7918514/MEGA-Tinyjoypad-for-ESP8266/schemes/List of Elements v1.1.pdf

### Перечень элементов v1.1

BAT | = 3V7 602540 (6mm*25mm*40mm)
C1 | = 100n (0805)
C2 | = 100n (0805)
C3 | = 470uF*6.3V (Tantal Case E)
C4 | = 100n (0805)
C5 | = 10uF (0805)
C6 | = 10uF (0805)
C7 | = 22uF (0805)
C8 | = 22uF (0805)
C9 | = 10uF (0805)
C10 | = 10uF (0805)
D1 | = SK34 (SMA (DO-214AC))
D2 | = SK34 (SMA (DO-214AC))
D3 | = SK34 (SMA (DO-214AC))
D4 | = Red (0805)
D5 | = Green (0805 (KPBA-3010ESGC))
D6 | = RS1M (SMA (DO-214AC))
D7 | = RS1M (SMA (DO-214AC))
D8 | = White (d=3mm)
JP1 | = ПП (Перемычка припоем)
JP2 | = ПП (Перемычка припоем)
JP3 | = ПП (Перемычка припоем)
K1 | = MSK-12D19 (ISF-1260) Link1 (https://aliexpress.ru/item/4001202080623.html?sku_id=10000015286215548) Link2 (https://aliexpress.ru/item/1005004659954284.html?sku_id=12000034673467435) Link3 (https://aliexpress.ru/item/33009763749.html?sku_id=67133660852)
K2 | = MSK-12C02 (IS-1290A) Link1 (https://aliexpress.ru/item/4000685483225.html?sku_id=12000037044894568)
K3 | = MSK-12C02 (IS-1290A)
K4 | = MSK-12C02 (IS-1290A)
L1 | = 10uH (SH4028-100YLB)
M1 | = Vibration Motor (Eccentric Rotating Mass (∅8x3.4mm)) (https://aliexpress.ru/item/1005006072681788.html)
Q1 | = WM02P60M2 (SOT-23-3 P-Channel MOSFET)
Q2 | = WM02N28M (SOT-23-3 N-Channel MOSFET)
Q3 | = WM02N28M (SOT-23-3 N-Channel MOSFET)
Q4 | = WM02N28M (SOT-23-3 N-Channel MOSFET)
R1 | = 5k1 (0805)
R2 | = 5k1 (0805)
R3 | = 220k (0805)
R4 | = 62k (0805)
R5 | = 10k (0805)
R6 | = 10k (0805)
R7 | = 10k (0805)
R8 | = 10k (0805)
R9 | = 10k (0805)
R10 | = 10k (0805)
R11 | = 10k (0805)
R12 | = 10k (0805)
R13 | = 10k (0805)
R14 | = 10k (0805)
R15 | = 110k (0805 (или R15 220k + R16 30k))
R16 | = 15k (0805 (или R15 220k + R16 30k))
R17 | = 10k (0805)
R18 | = 1k (0805)
R19 | = 1k (510) (0805)
R20 | = 1k (470) (0805)
R21 | = 3k3 (0805)
R22 | = 1k (0805)
R23 | = 30k (0805)
R24 | = 1k (0805)
R25 | = 30k (0805)
R26 | = 10 (0805)
R27 | = 3362W-1-501 (Резистор переменный 500 Ом) (https://aliexpress.ru/item/1005001679113612.html)
R28 | = 1k (0805)
R29 | = 30k (0805)
R30 | = 47 (0805)
R* | = 10k (0805 (Не устанавливать))

S1 | = IT-1199 (https://aliexpress.ru/item/4001158109967.html) (RESET)
S2 | = IT-1199 (UP)
S3 | = IT-1199 (UP)
S4 | = IT-1199 (LEFT)
S5 | = IT-1199 (RIGHT)
S6 | = IT-1199 (DOWN)
S7 | = IT-1199 (START)
S8 | = IT-1199 (B)
S9 | = Кнопка тактовая (3.5x4.7mm) (https://aliexpress.ru/item/32802358763.html)
SP1 | = Passive Buzzer 0905 16R (9x5.5mm (hole 4.0mm)) (https://aliexpress.ru/item/32857436073.html)
U1 | = CH340N (SOP-8)
U2 | = OLED (SSD1306 1.54'' 128x64 I2C 4Pin DRIVER IC: 1309) (https://aliexpress.ru/item/1005004403427456.html)
U3 | = ESP12F (https://aliexpress.ru/item/32256161821.html)
U4 | = RT9013-33GB (ME6211C33) (SOT-23-5)
U5 | = SDB628 (SOT-23-6)
U6 | = TP4057 (SOT-23-6 (57b1))
X1 | = USB Type-C (DS1144-18-16FS8BNR0)
X2 | = DS1002-01-4 (Разъем цанговый, мама+папа) (https://aliexpress.ru/item/1005007331511033.html)
X3 | = CWF-5R (L-KLS1-2.50-05-R) (https://aliexpress.ru/item/1005003169239623.html)
Y1 | = Taptic Engine (iPhone 6) (https://aliexpress.ru/item/1005006289568035.html)

Стойка латунная М2.5*12мм (https://aliexpress.ru/item/1005004459634650.html) – 4шт

Стойка латунная М2.5*8мм (https://aliexpress.ru/item/1005004459634650.html) – 4шт

Винт М2.5*5мм (https://aliexpress.ru/item/1005002525560135.html) – 16шт

Винт М1.6*6мм (https://aliexpress.ru/item/1005002525560135.html) – 2шт (крепление Taptic Engine)

Гайка М1.6 (https://aliexpress.ru/item/1005002856385340.html) – 2шт (крепление Taptic Engine)

Крестик джойстика Gameboy Pocket GBP (https://aliexpress.ru/item/1005006164932167.html) – 1шт

Колпачок для кнопки 102 ∅7.5мм (https://aliexpress.ru/item/1005002085295869.html) – 3шт

Колпачок для кнопки A101 ∅5.5мм (https://aliexpress.ru/item/1005004784765029.html) – 1шт

Стекло защитное Xiaomi Miband 8 Pro (https://aliexpress.ru/item/1005006137168319.html) – 1шт (защита экрана)
