7918514/MEGA-Tinyjoypad-for-ESP8266/pcb/front_panel_v1.2.png

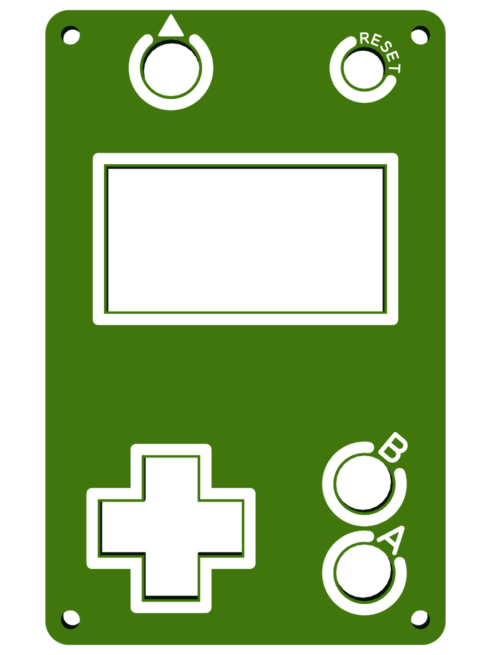
pcb/front_panel_v1.2.png
