7918514/MEGA-Tinyjoypad-for-ESP8266/pcb/main_board_v1.2_bot.png

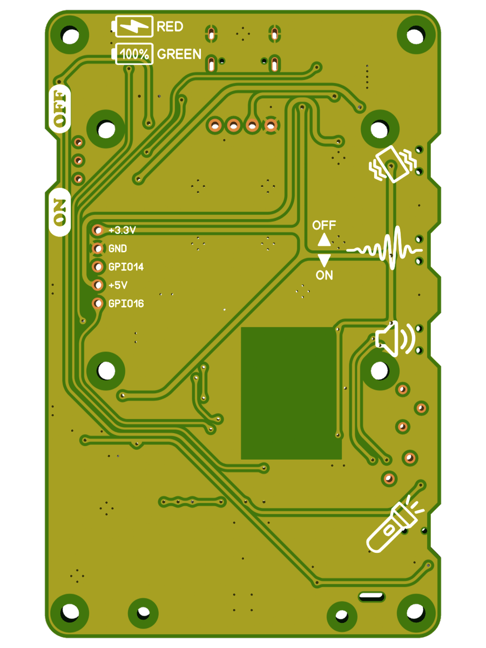
pcb/main_board_v1.2_bot.png
