7918514/MEGA-Tinyjoypad-for-ESP8266/pcb/main_board_v1.2_top.png

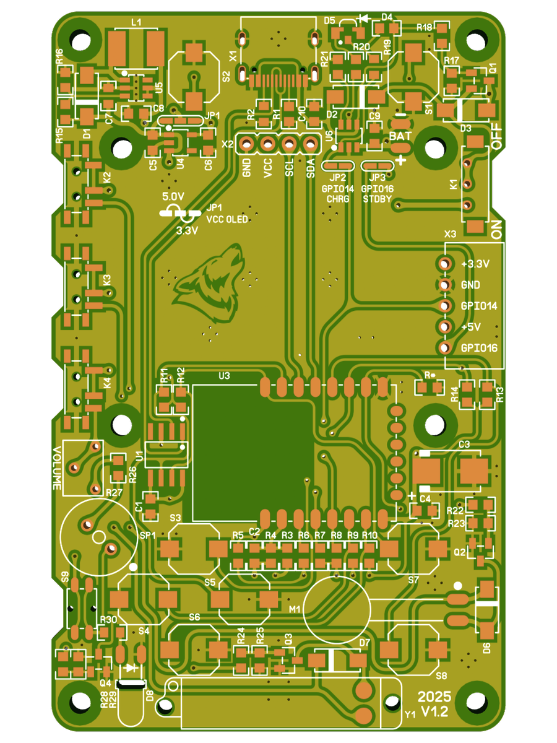
pcb/main_board_v1.2_top.png
