7918514/MEGA-Tinyjoypad-for-ESP8266/photo/001 front side.jpg

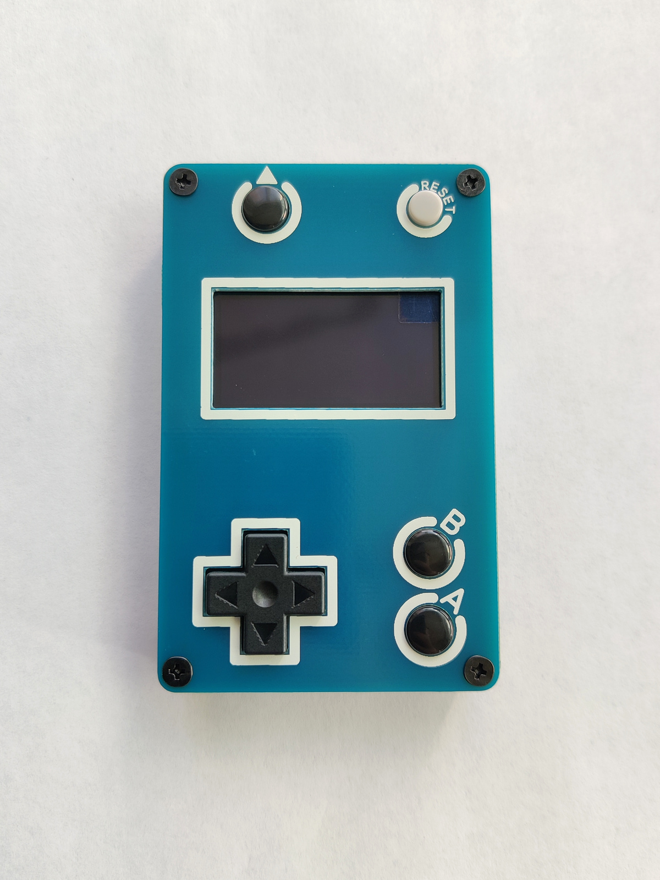
photo/001 front side.jpg
