7918514/MEGA-Tinyjoypad-for-ESP8266/photo/002 back side.jpg

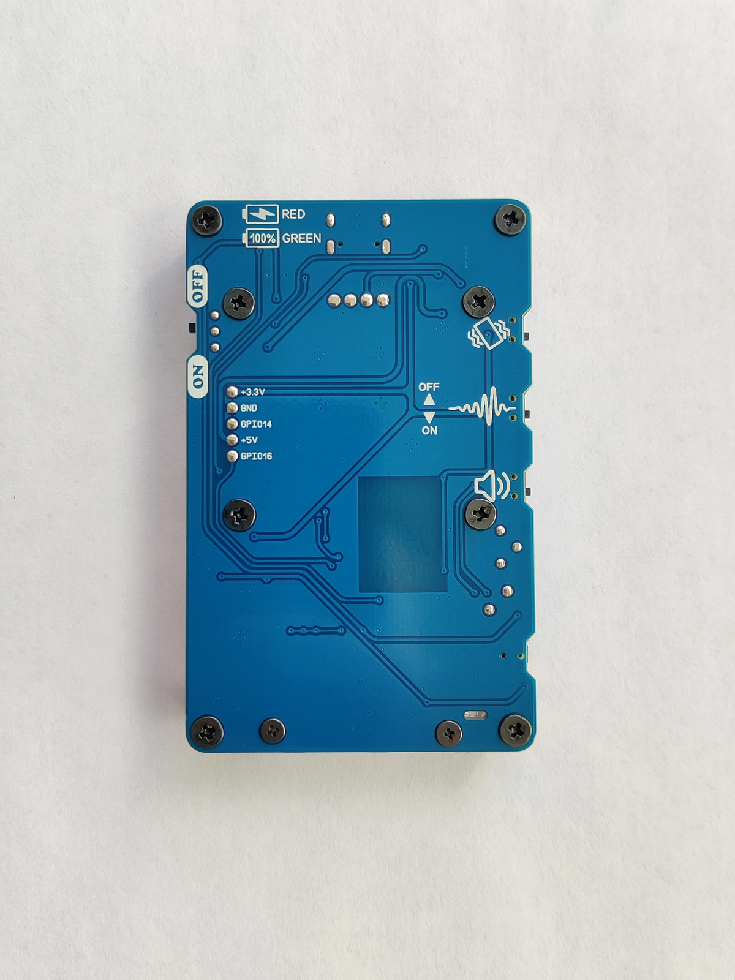
photo/002 back side.jpg
