7918514/MEGA-Tinyjoypad-for-ESP8266/photo/003.jpg

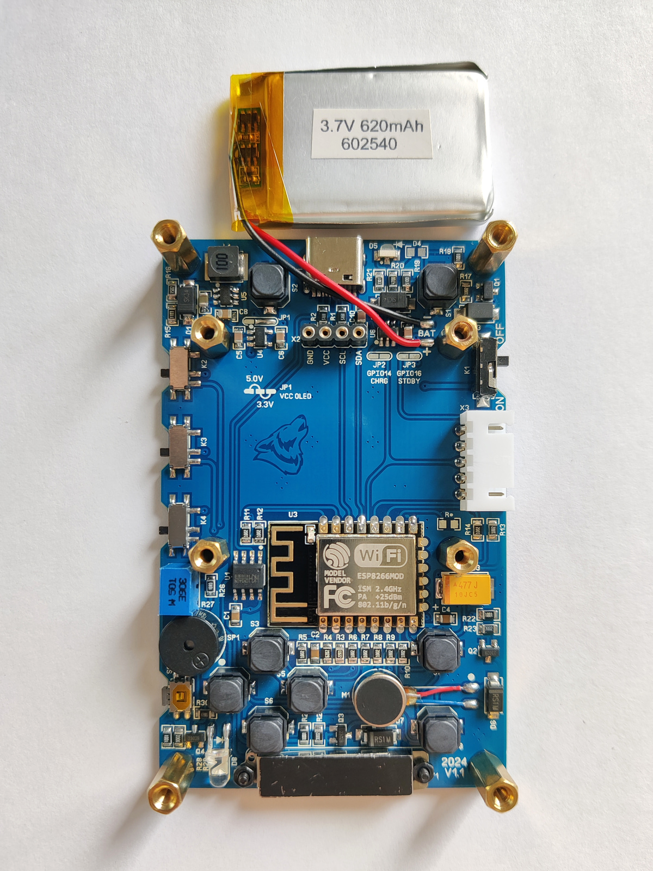
photo/003.jpg
