7918514/MEGA-Tinyjoypad-for-ESP8266/photo/004.jpg

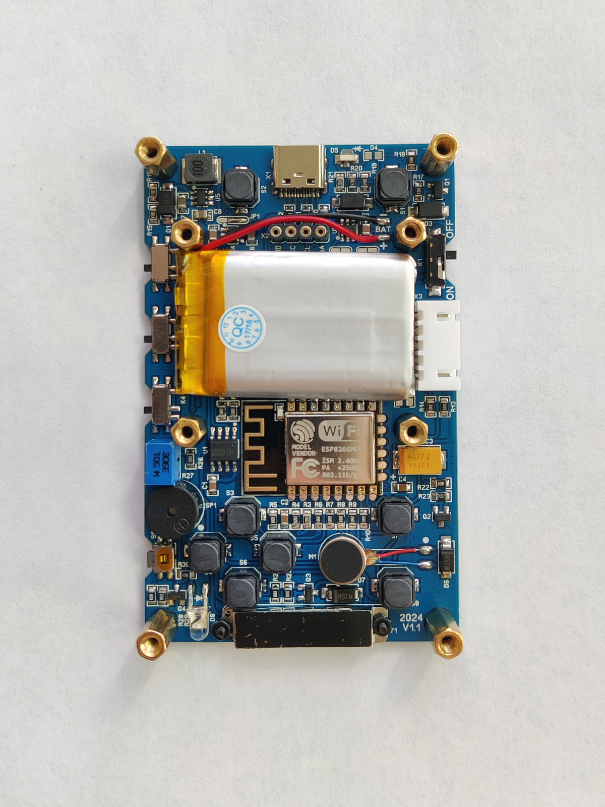
photo/004.jpg
