7918514/MEGA-Tinyjoypad-for-ESP8266/photo/005.jpg

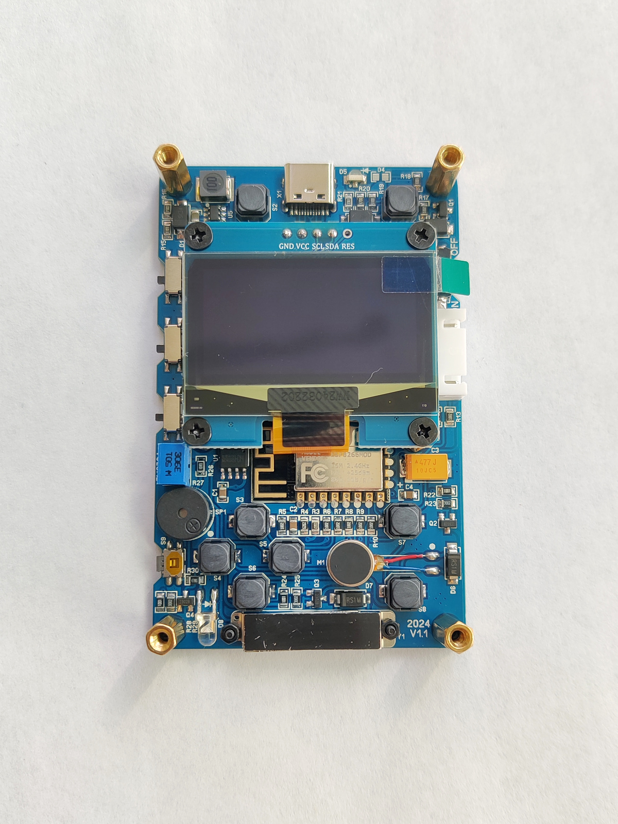
photo/005.jpg
