7918514/MEGA-Tinyjoypad-for-ESP8266/photo/006.jpg

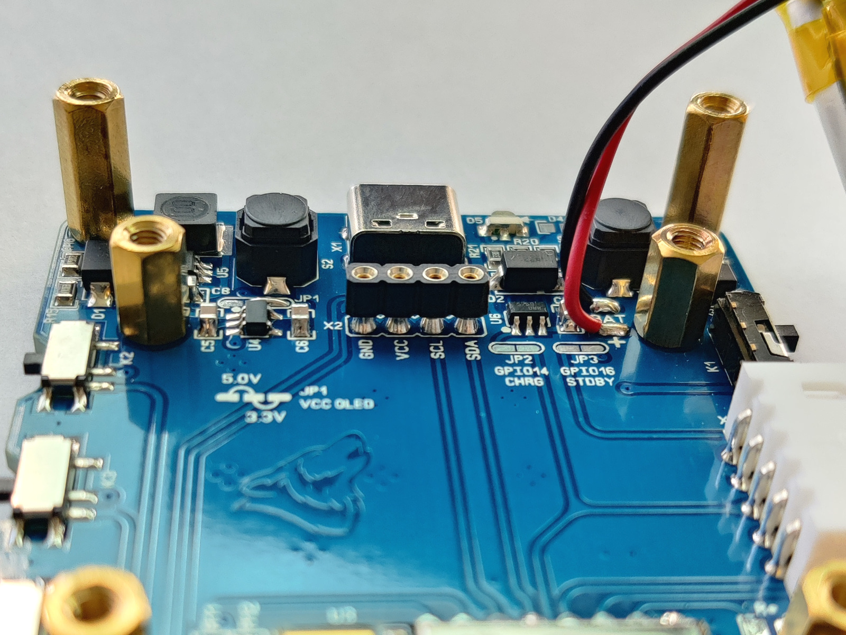
photo/006.jpg
