7918514/MEGA-Tinyjoypad-for-ESP8266/photo/007.jpg

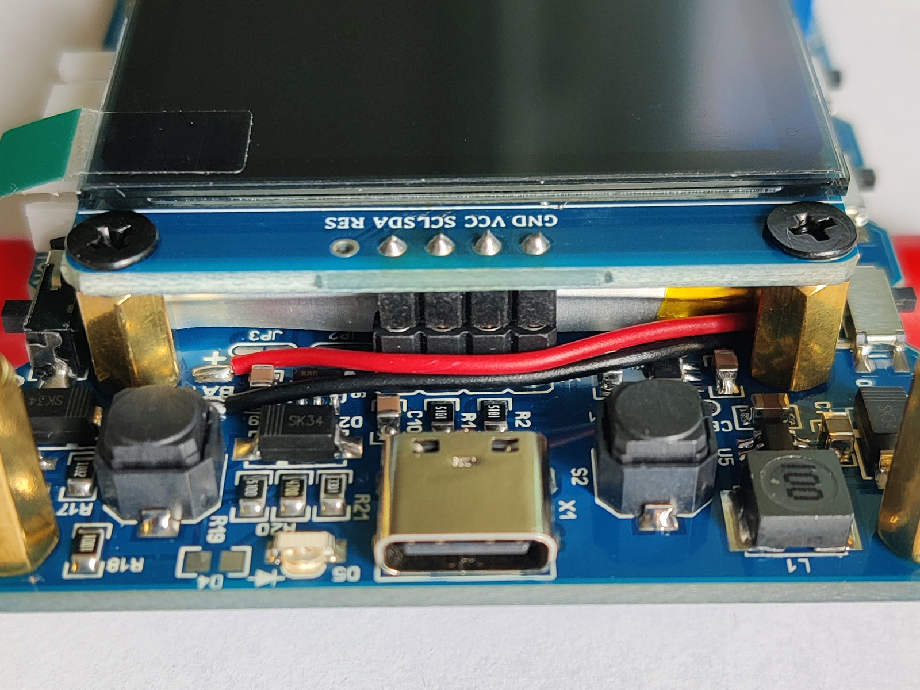
photo/007.jpg
