7918514/MEGA-Tinyjoypad-for-ESP8266/photo/008.jpg

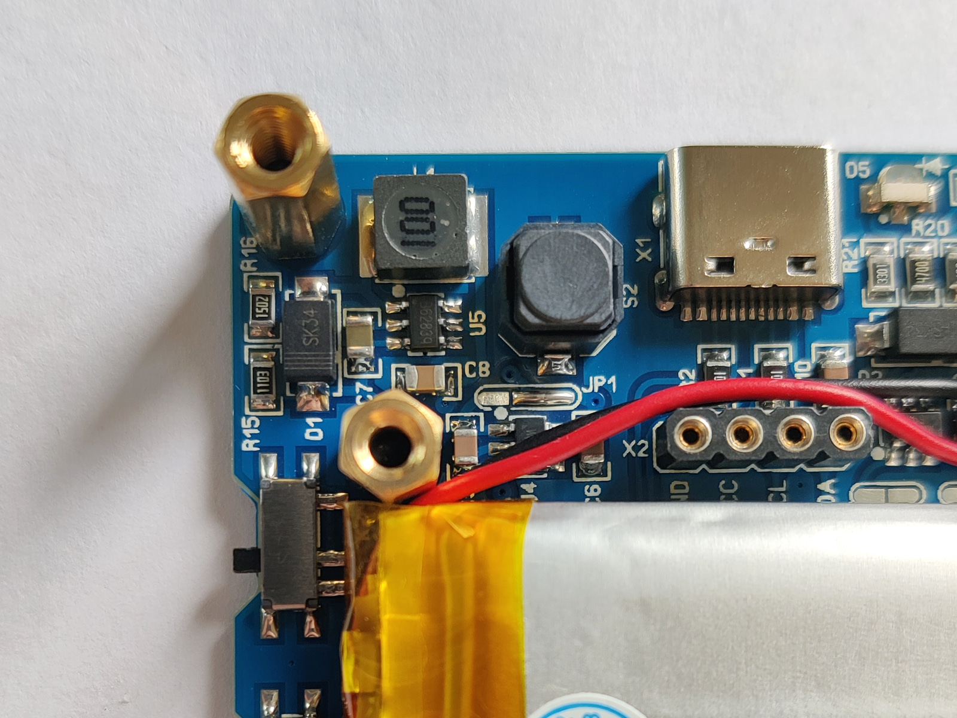
photo/008.jpg
