7918514/MEGA-Tinyjoypad-for-ESP8266/photo/009.jpg

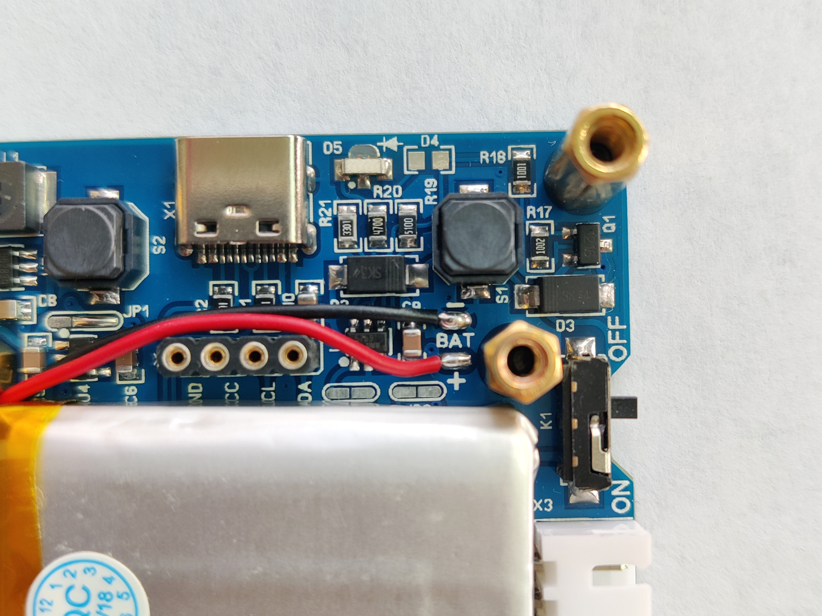
photo/009.jpg
