7918514/MEGA-Tinyjoypad-for-ESP8266/photo/010.jpg

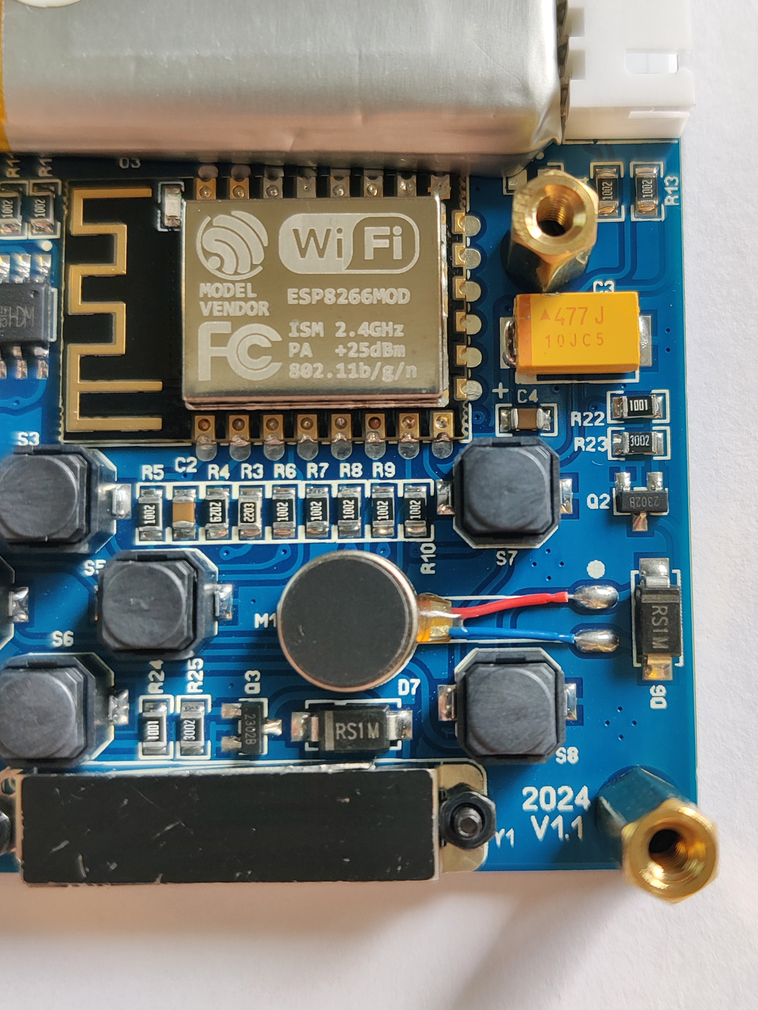
photo/010.jpg
