7918514/MEGA-Tinyjoypad-for-ESP8266/photo/011.jpg

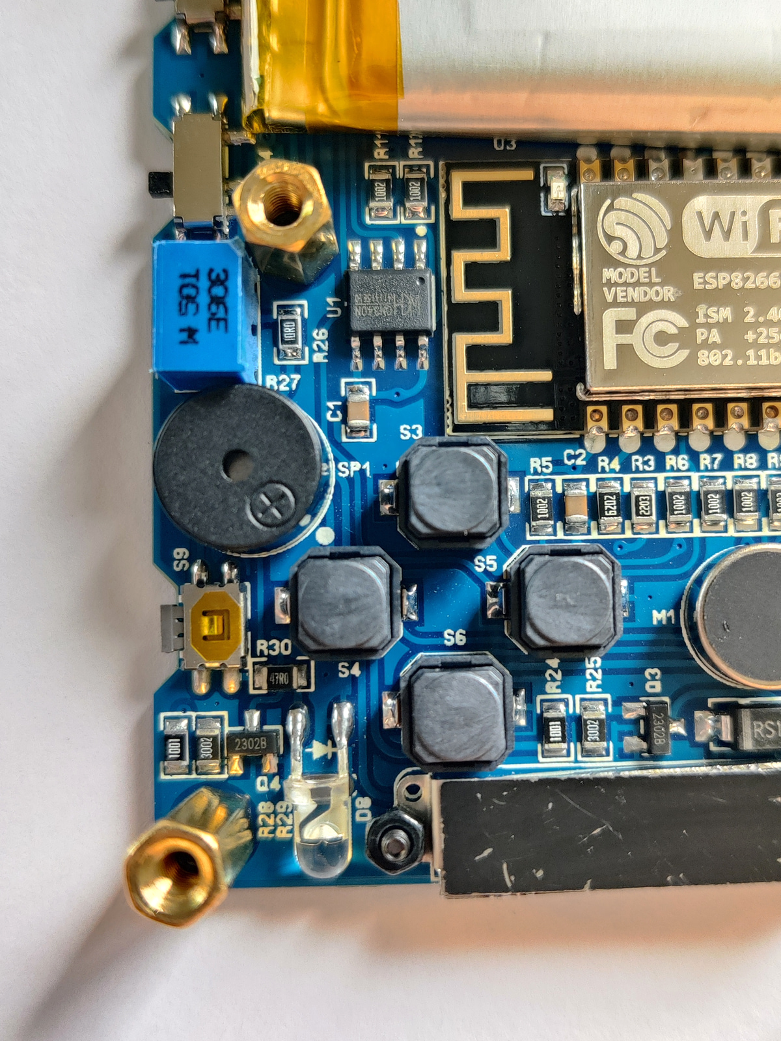
photo/011.jpg
