7918514/MEGA-Tinyjoypad-for-ESP8266/photo/buttons 1.jpg

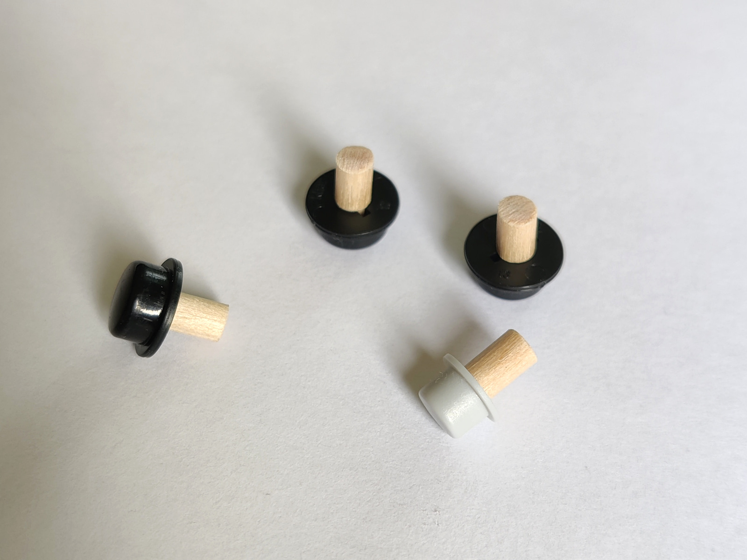
photo/buttons 1.jpg
