7918514/MEGA-Tinyjoypad-for-ESP8266/photo/buttons 2.jpg

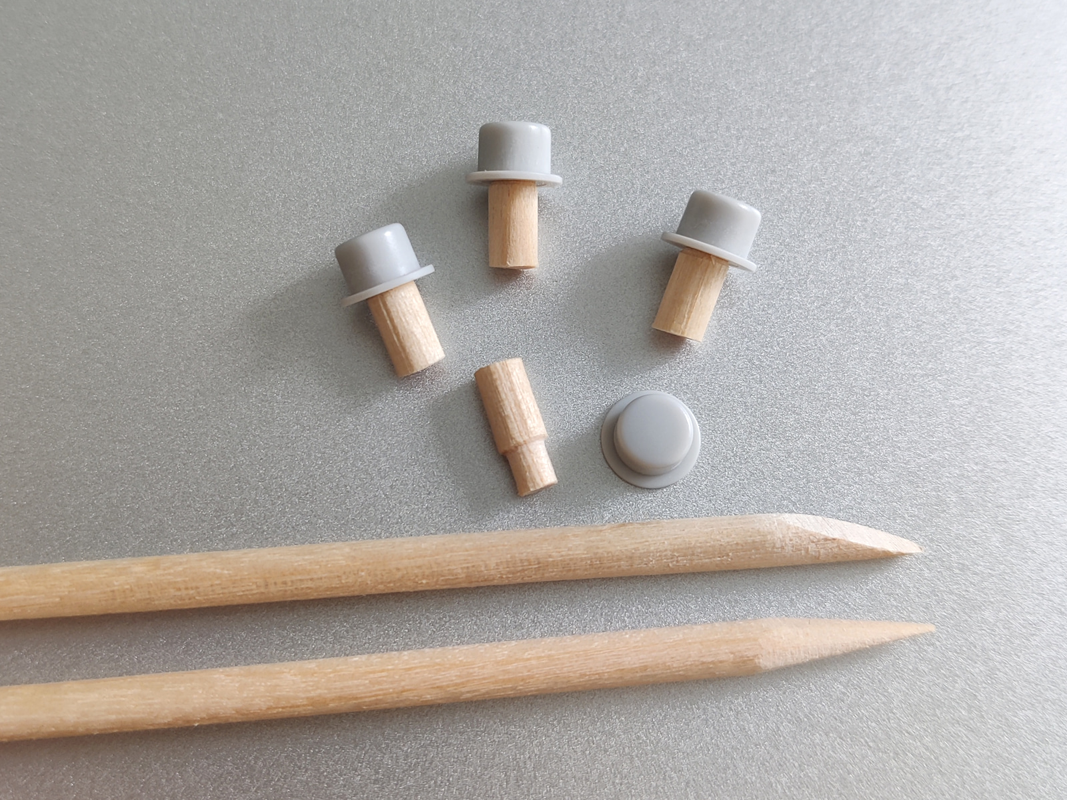
photo/buttons 2.jpg
