7918514/MEGA-Tinyjoypad-for-ESP8266/photo/display name.jpg

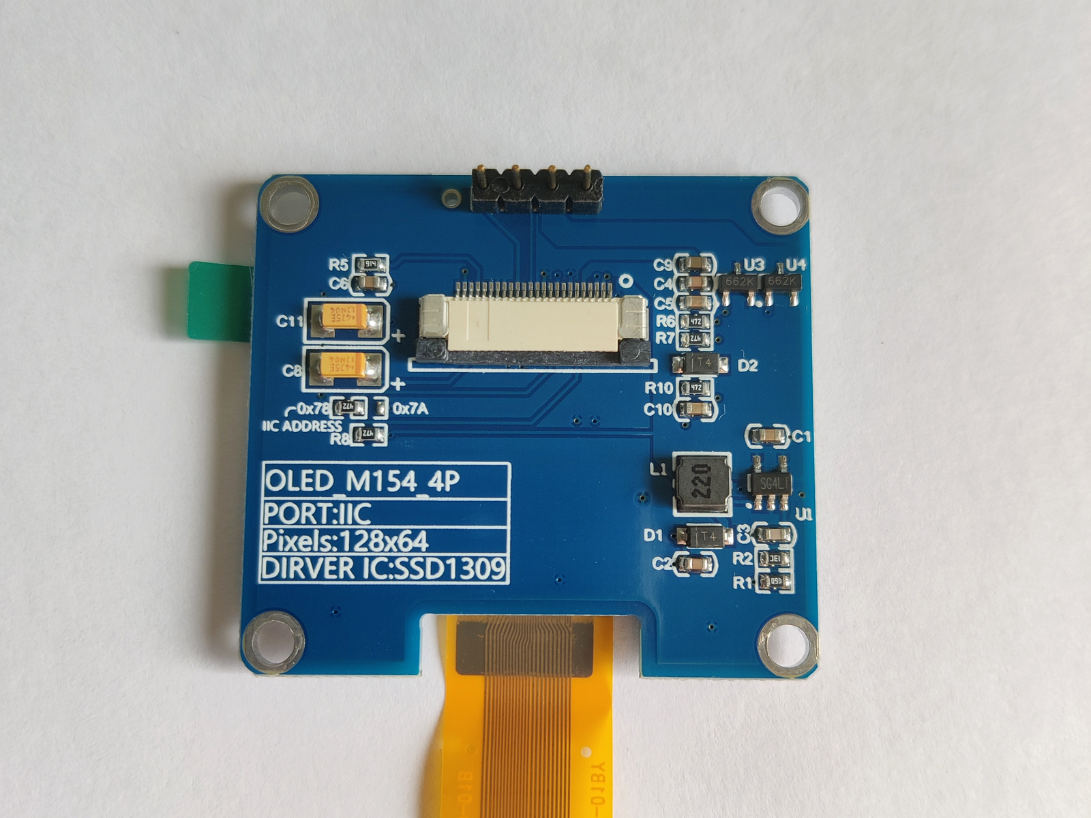
photo/display name.jpg
