7918514/MEGA-Tinyjoypad-for-ESP8266/photo/joystick.jpg

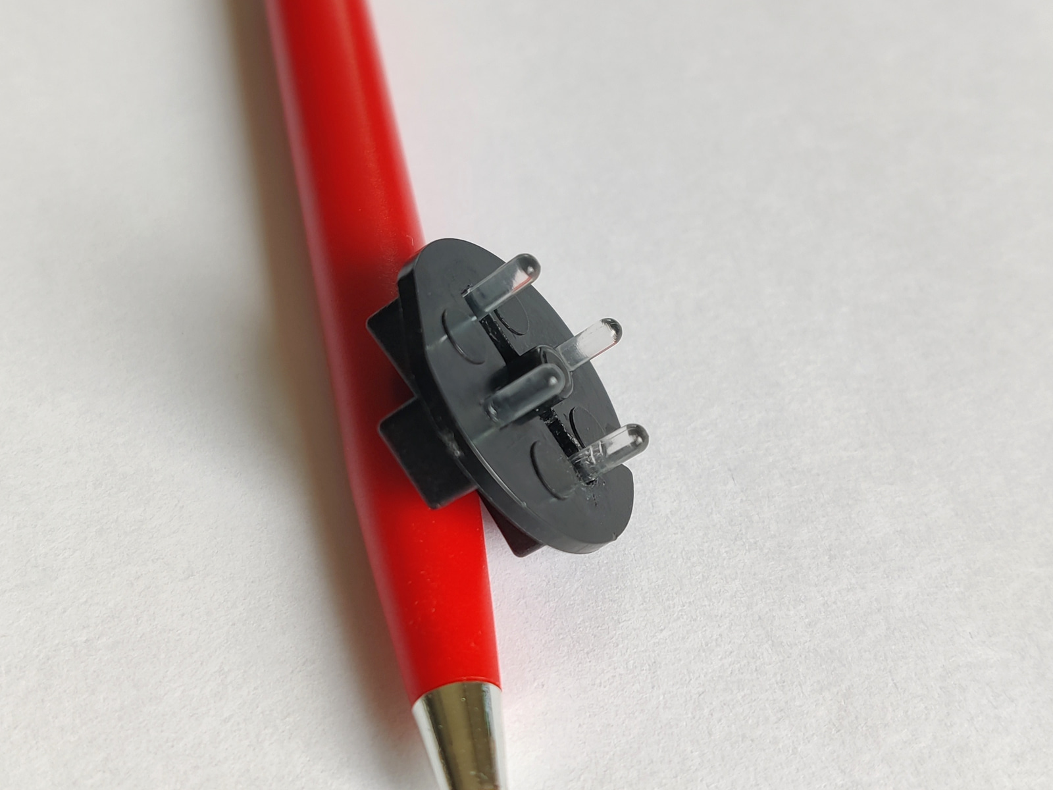
photo/joystick.jpg
