7918514/MEGA-Tinyjoypad-for-ESP8266/firmware/test/README.md

Разные прошивки для устройства не относящиеся к основному проекту
