7918514/MEGA-Tinyjoypad-for-ESP8266/firmware/test/battery_voltage_on_the_display/scheme.jpg

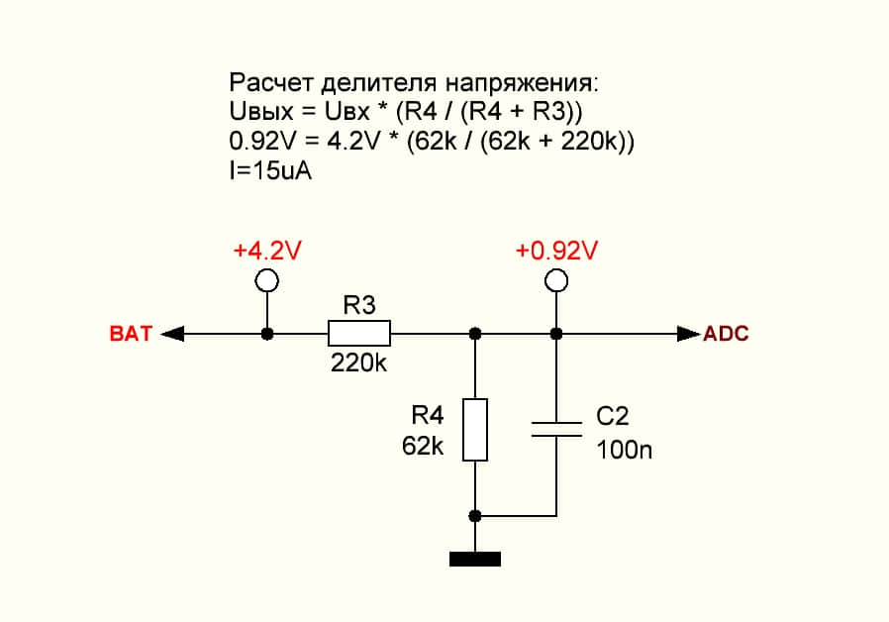
firmware/test/battery_voltage_on_the_display/scheme.jpg
