7918514/MEGA-Tinyjoypad-for-ESP8266/schemes/Schemes v1.1.pdf

# MEGA Tinyjoypad for ESP8266 v1.1

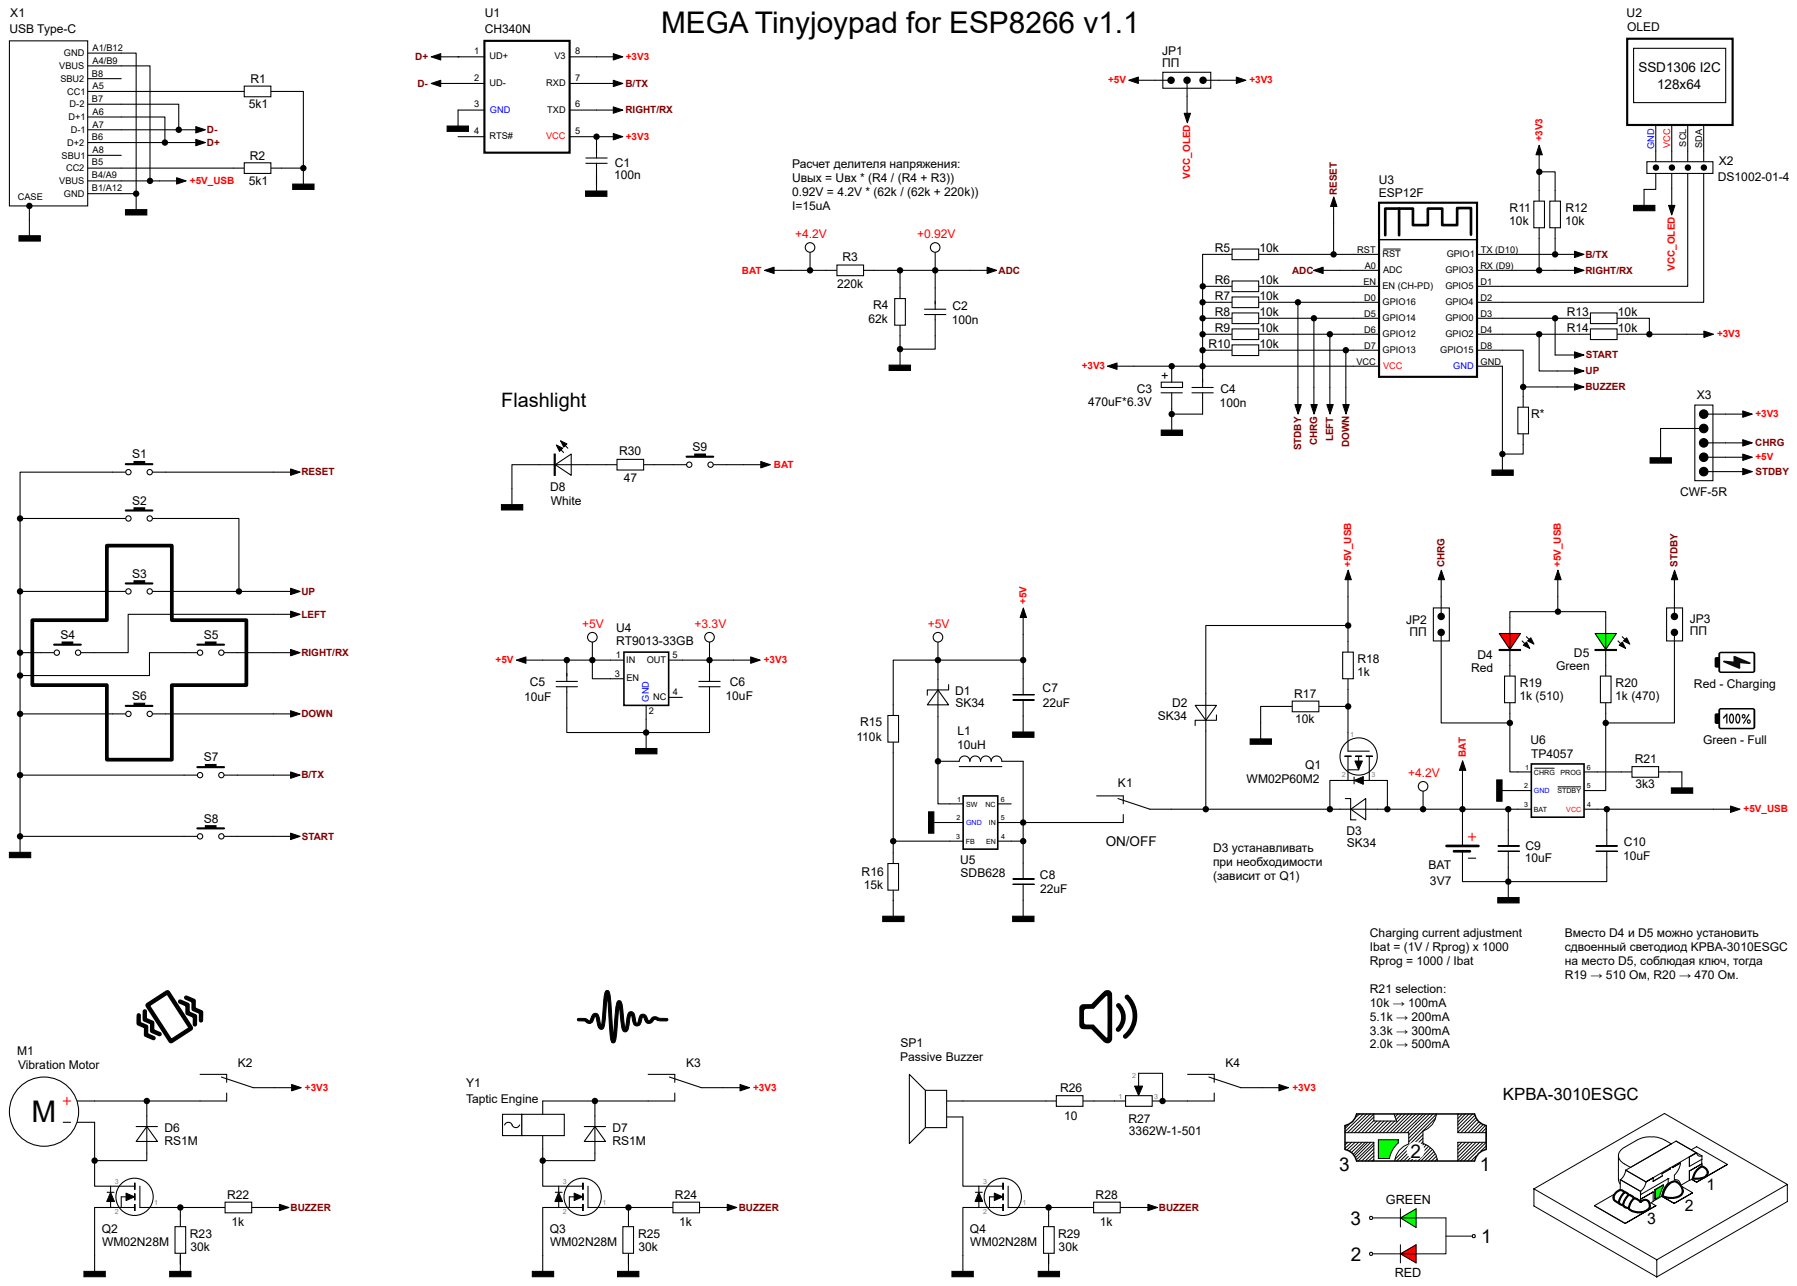
[picture p39: page 1]

Вместо D4 и D5 можно установить
сдвоенный светодиод KPBA-3010ESGC
на место D5, соблюдая ключ, тогда
