7918514/MEGA-Tinyjoypad-for-ESP8266/firmware/MEGAcompilation160mhz_v0027/MENU_ESP.h

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
//---------------------------------------------------------------------------------
//      This COMPILATION uses code created by Roger Buehler
// Tiny Lander under GPLv3 for ATTINY85  https://github.com/tscha70/ 
//                  Contact EMAIL: tscha70@gmail.com
//---------------------------------------------------------------------------------
// These Libraries used for Mega Tinyjoypad ESP82xx are NOT included in this source code.
//                  (Refer to the "Library_License.txt" file.)
//  1- ESP8266WiFi.h  // Copyright (c) 2011-2014 Arduino.  All right reserved.
//                       Modified by Ivan Grokhotkov, December 2014.
//  2- Wire.h         // Copyright (c) 2006 Nicholas Zambetti.  All right reserved.

//  3- SSD1306.h      // Copyright (c) 2018 by ThingPulse, Daniel Eichhorn Copyright

//  4- Arduino.h      // Copyright (c) 2005-2013 Arduino Team.  All right reserved.

//  5- avr/pgmspace.h // Copyright (c) 2002-2007  Marek Michalkiewicz Copyright (c) 2006,
//                       Carlos Lamas Copyright (c) 2009-2010, Jan Waclawek All rights reserved.
//---------------------------------------------------------------------------------

// ACTUAL GAME LIST
//  1-Tiny Lander by (c)Roger Buehler 2020 GPLv3  https://github.com/tscha70/  Contact EMAIL: tscha70@gmail.com
//  2-Tiny Gilbert (Electro L.I.B)
//  3-Tiny Trick (Electro L.I.B)
//  4-Tiny Space Invaders (Electro L.I.B)
//  5-Tiny Pinball (Electro L.I.B)
//  6-Tiny Pacman (Electro L.I.B)
//  7-Tiny Bomber (Electro L.I.B)
//  8-Tiny Bike (Electro L.I.B)
//  9-Tiny Bert (Electro L.I.B)
//  10-Tiny Arkanoid (Electro L.I.B)
//  11-Tiny Tris (Electro L.I.B)
//  12-Tiny Plaque (Electro L.I.B)
//  13-Tiny DDug (Electro L.I.B)
//  14-Tiny Missile (Electro L.I.B)
//  15-Tiny Morpion (Electro L.I.B)
//  16-Tiny Pipe (Electro L.I.B)
//  17-Tiny SQuest (Electro L.I.B)
//  18-Ardumania (Electro L.I.B) v1.3
//  19-Nohzdyve (Electro L.I.B) 
//  20-Gilbert in the Downland (Electro L.I.B) (2025)
//  21-Tiny-Doc (Electro L.I.B) (2025)
//  22-Tiny Arena (Électro L.I.B) -> NEW (2026)

// ACTUAL FONCTION
//----------------
//  1-SOUND On/Off    => Access by std MENU, key Down (if you write permanently your choice, push button for 3 sec)
//                     -> New feature for adjusting contrast: In the audio menu, press the up key and push the action button
//                        to adjust the desired contrast level. The contrast level is automatically saved in the audio settings at the same time.

//  2-clear EEPROM    => Access by std MENU, key Up (Clear EEPROM => key right and push the action button for 3 sec)
//                     -> New feature to delete the backup of a specific game: select the game, open the EEPROM menu with the up key,
//                       then press the right key and while holding down the right key, press the action button for 3 seconds to erase the backup.

//  3-CONTROL TESTER  => Access by Startup (power on, after 0.2 sec press button for 2 sec.

//  for ESP8266/ESP8285 at 160 Mhz
//  PROGRAM with "LOLIN (WEMOS) D1 mini lite"board for D1 mini lite ESP8266/ESP8285
//   or PROGRAM with "GENERIC ESP82xx MODULE" for generic board
//  Programmer = AVRISP mkii

#include <Arduino.h> // Copyright (c) 2005-2013 Arduino Team.  All right reserved. (Refer to the "Library_License.txt" file.)
#include <avr/pgmspace.h> // Copyright (c) 2002-2007  Marek Michalkiewicz Copyright (c) 2006, Carlos Lamas Copyright (c) 2009-2010, Jan Waclawek All rights reserved. (Refer to the "Library_License.txt" file.)

#define SDA_ 4 //SDA
#define SCL_ 5 //SCL
SSD1306  display(0x3c,SDA_,SCL_);//pin D1 and D2 on ESP8266 / ESP8285
uint8_t SOUND_ON_OFF=LOW;
unsigned long currentMillis=0;
unsigned long MemMillis=0;
/*
#define _delay_ms(DEL_ms) delay(DEL_ms)
#define _delay_us(DEL_us) delayMicroseconds(DEL_us)
*/
//#define My_delay_ms(DEL_ms) myDelay(DEL_ms)// for 80 mhz
//#define My_delay_us(DEL_us) myDelayus(DEL_us)// for 80 mhz

#define My_delay_ms(DEL_ms) delay(DEL_ms) //use for 160 mhz config
#define My_delay_us(DEL_us) delayMicroseconds(DEL_us) //use for 160 mhz config

void myDelay(uint16_t del) {
  unsigned long ending = millis()+del;
  while (millis()+1 < ending) {
  }
}

void myDelayus(uint16_t del) {
  unsigned long ending = micros()+del;
  while (micros()+1 < ending) {
  }
}

#define PIN_ 15 //Dima
#define PIN_START_BUTTON 0
#define PIN_RIGHT_BUTTON 3 //Dima
#define PIN_DOWN_BUTTON 13 //Dima
#define PIN_LEFT_BUTTON 12 //Dima
#define PIN_UP_BUTTON 2

#define TINYJOYPAD_LEFT  (digitalRead(PIN_LEFT_BUTTON))
#define TINYJOYPAD_RIGHT (digitalRead(PIN_RIGHT_BUTTON))
#define TINYJOYPAD_DOWN (digitalRead(PIN_DOWN_BUTTON))
#define TINYJOYPAD_UP  (digitalRead(PIN_UP_BUTTON))

#define BUTTON_DOWN (digitalRead(PIN_START_BUTTON)==0)
#define BUTTON_UP (digitalRead(PIN_START_BUTTON)==1)


typedef struct GROUPE_MENU{

}GROUPE_MENU;

const uint8_t  MENU_FADE [] PROGMEM= {
0b00000000,
0b00000000,

0b00000010,
0b01000000,

0b00010010,
0b01000100,

0b01010010,
0b01000101,

0b01011010,
0b01010101,

0b11011010,
0b01010111,

0b11011110,
0b01110111,

0b11111110,
0b01111111,

0b11111111, 
0b11111111, 
};

const uint8_t  police_MEGA [] PROGMEM= {
4,1,
0xF8,0x88,0xF8,0x00,0x00,0xF8,0x00,0x00,0xE8,0xA8,0xB8,0x00,0x88,0xA8,0xF8,0x00,0x38,0x20,0xF8,0x00,
0xB8,0xA8,0xE8,0x00,0xF8,0xA8,0xE8,0x00,0x08,0xE8,0x18,0x00,0xF8,0xA8,0xF8,0x00,0xB8,0xA8,0xF8,0x00,
};

const uint8_t  MENU_VIGNETTE [] PROGMEM= {
128,8,
// tiny lander by Roger
0x00,0x00,0x00,0x00,0x00,0xC0,0x60,0xA0,0xB0,0xD0,0xD0,0xD0,0xD0,0xD0,0xD0,0xD0,0xD0,0xD0,0xD0,0xD0,
0xD0,0xD0,0xD0,0xD0,0xD0,0xD0,0xD0,0xD0,0xD0,0xD0,0xD0,0xD0,0xD0,0xD0,0xD0,0xD0,0xD0,0xD0,0xD0,0xD0,
0xD0,0xD0,0xD0,0xD0,0xD0,0xD0,0xD0,0xD0,0xD0,0xD0,0xD0,0xD0,0xD0,0xD0,0xD0,0xD0,0xD0,0xD0,0xD0,0xD0,
0xD0,0xD0,0xD0,0xD0,0xD0,0xD0,0xD0,0xD0,0xD0,0xD0,0xD0,0xD0,0xD0,0xD0,0xD0,0xD0,0xD0,0xD0,0xD0,0xD0,
0xD0,0xD0,0xD0,0xD0,0xD0,0xD0,0xD0,0xD0,0xD0,0xD0,0xD0,0xD0,0xD0,0xD0,0xD0,0xD0,0xD0,0xD0,0xD0,0xD0,
0xD0,0xD0,0xD0,0xD0,0xD0,0xD0,0xD0,0xD0,0xD0,0xD0,0xD0,0xD0,0xD0,0xD0,0xD0,0xD0,0xD0,0xD0,0xD0,0xB0,
0xA0,0x60,0xC0,0x00,0x00,0x00,0x00,0x00,0x00,0x00,0x00,0x00,0xFF,0x01,0xFE,0xFF,0xFF,0xFF,0xFF,0xFF,
0xFF,0xFF,0xFD,0xFD,0xFD,0x01,0x01,0xFD,0xFD,0xFD,0xFF,0xFF,0xEF,0x09,0x09,0xFF,0xFF,0xFF,0x0F,0x0F,
0xEF,0xEF,0xEF,0x0F,0x1F,0xFF,0x0F,0x0F,0xFF,0xFF,0xFF,0x0F,0x0F,0xFF,0xFF,0xFF,0xFF,0xFF,0xFF,0xFF,
0xFF,0xFF,0xFF,0xFF,0xFF,0xFF,0xFF,0xFF,0xFF,0xFF,0xFF,0xFF,0xFF,0xFF,0xFF,0xFF,0xFF,0xFF,0xFF,0xFF,
0xFF,0xFF,0xFF,0xFF,0xFF,0xFF,0xFF,0xFF,0xFF,0xFF,0xFF,0xFF,0xFF,0xFF,0xFF,0xFF,0xFF,0xFF,0xFF,0xFF,
0xFF,0xFF,0xFF,0xFF,0xFF,0xFF,0xFF,0xFF,0xFF,0xFF,0xFF,0xFF,0xFF,0xFF,0xFF,0xFF,0xFF,0xFF,0xFF,0xFF,
0xFF,0xFF,0xFF,0xFF,0xFF,0xFF,0xFF,0xFF,0xFF,0xFE,0x01,0xFF,0x00,0x00,0x00,0x00,0x00,0x00,0x00,0x00,
0xFF,0x00,0xFF,0xFF,0xFF,0xFF,0xFF,0xFF,0xFF,0xFF,0xFF,0xFF,0xFF,0xF8,0xF8,0xFF,0xFF,0xFF,0xFF,0xFF,
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
0x0B,0x0B,0x0B,0x0B,0x0B,0x0B,0x0B,0x0B,0x0B,0x0B,0x0B,0x0B,0x0B,0x0B,0x0B,0x0B,0x0B,0x0B,0x0B,0x0B,
0x0B,0x0B,0x0B,0x0B,0x0B,0x0B,0x0B,0x0B,0x0B,0x0B,0x0B,0x0B,0x0B,0x0B,0x0B,0x0B,0x09,0x05,0x04,0x02,
0x01,0x00,
};
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
