7918514/MEGA-Tinyjoypad-for-ESP8266/(commit log)

2026-01-30 Обновил прошивку до v0027
2026-06-07 Добавил тестовые прошивки. Обновил библиотеки
