7918514/MEGA-Tinyjoypad-for-ESP8266/(notices)

Notices in the files:
firmware/MEGAcompilation160mhz_v0027/DATA/TINYLANDER/tiny-lander-ESP.h:
>>>>> T-I-N-Y L-A-N-D-E-R v1.0 for ATTINY85 GPLv3 <<<<
Tiny Lander v1.0 is free software: you can redistribute it and/or modify
